wanjin1234/Silent-Mask-Microphone/microphone/windows/使用说明.txt

树莓派网络麦克风 · Windows 端
================================

这个文件夹里是电脑侧的程序，接收树莓派降噪后的麦克风音频并播放，同时把电脑的
声音（系统回环或麦克风）发回树莓派耳机口。

一、安装（只做一次）
--------------------
1) 装 Python 3.8 以上（https://www.python.org/downloads/ ，安装时勾选
   "Add python.exe to PATH"）。
2) 双击 **启动.bat**：它会自动执行 pip install soundcard numpy 然后打开界面。
   也可以手动：
       pip install -r requirements.txt
       python btmic_net_gui.py
   国内网络慢时加镜像：
       pip install -r requirements.txt -i https://pypi.tuna.tsinghua.edu.cn/simple

二、使用
--------
1) 界面上选连接方式：
     * TCP 直连 —— 树莓派和电脑在同一 WiFi/热点时用；电脑要有公网 IP 或做了
       内网穿透时，跨互联网也能用（音质最好：48kHz 立体声）。
     * MQTT 中继 —— 只要双方都能上网就行，不需要公网 IP（中继模式的音质和
       稳定性受免费 broker 限制）。
2) 点 **启动服务**。第一次会弹 Windows 防火墙提示，选"允许访问"。
   * **谁先开机都行**：树莓派连不上会每 4 秒重试一次，这里一点"启动服务"就接上；
     中途关掉本程序、之后再打开，树莓派也会自动重连，不用重启树莓派。
3) 点 **把连接参数复制给树莓派**，把复制到的命令粘到树莓派 SSH 里执行。
4) 底部 **音频自检** 可以在没连树莓派时先确认"电脑这边有没有声音"。

> 树莓派侧还有**智能切换蓝牙**：没有网络连接（比如这边还没启动服务）时它会自动
> 把蓝牙服务拉起来，手机/电脑可以继续用蓝牙；这边一启动服务，树莓派自动关掉蓝牙、
> 切到网络。详见上一级目录《4G模块安装与网络音频使用说明.md》的「六bis」一节。

三、界面上各块是干什么的
------------------------
① 连接设置：端口/broker/令牌（令牌两端必须一致，点"换一个"随机生成）
② 上行：树莓派麦克风 → 电脑。选播放设备、调音量、勾"同时录音到 WAV"
③ 下行：电脑声音 → 树莓派耳机口。选采集来源（"系统声音·xxx（回环）"=
   电脑正在放的所有声音；"麦克风·xxx"=你说的话）、调音量、
   "远端麦克风增益"相当于给树莓派的麦克风调音量（0~15）
④ 状态：连接状态、收发帧数、抖动缓冲、往返延迟
⑤ 日志：出问题先看这里

四、注意事项
------------
* 树莓派与电脑在同一个房间演示时，电脑建议戴耳机，否则会形成"树莓派喇叭 →
  树莓派麦克风 → 电脑 → 树莓派喇叭"的回声回路，可能啸叫。
* 下行格式（采样率/声道/帧长）**以树莓派宣布的为准**：树莓派开机时会把它的
  `NET_DOWNLINK_*` 通过握手告诉你，程序按它采集（日志里会写"按树莓派宣布的格式"）。
  界面上的"下行格式"只在树莓派还没宣布时兜底。两边不一致的后果是树莓派半速/变调
  播放（听感"低沉、失真"）——**所以不要用旧版程序**。
* ⚠️ 2026-09-27 修过一个 bug：旧版程序可能在收到树莓派的格式之前就按界面设置开始
  采集，导致上面那种变调/半速。**请使用随本次更新重新打包的
  `树莓派网络麦克风.exe`**（旧版已改名为桌面上的"旧版exe备份-可删.exe"，可直接删）。
* 完整说明（含 4G 模块安装、接线、固件、排查手册）见上一级目录的
  《4G模块安装与网络音频使用说明.md》。
* 改了界面上的设备/音量会存在 btmic_net_gui.json 里，下次自动带上。

五、自检（可选）
----------------
上一级的 tests/ 里有三个脚本，在本机跑一遍能验证协议与音频通路：
    python tests/test_proto.py      # 帧解析 + MQTT 报文解析 + 真 broker 收发
    python tests/test_e2e.py tcp    # 真声卡端到端（电脑↔"树莓派"双向音频）
    python tests/test_e2e.py mqtt   # 同上，走公共 broker

六、打包成单一 exe（免装 Python、没有控制台窗口）
------------------------------------------------
本目录里的 **树莓派网络麦克风.exe** 就是打包好的单文件程序（约 25MB）：
* 双击即用，**不需要装 Python**，也不会弹控制台窗口；「启动.bat」会优先用它。
* 配置与录音文件都保存在 **exe 旁边**（btmic_net_gui.json / *.wav）。
* 首次启动要解压自己，等 3~5 秒属正常。
* 没有数字签名，个别机器的 SmartScreen 会提示"未知发布者"——点"更多信息 → 仍要运行"。
* 想自己重新打包（改过源码后）：
      pip install pyinstaller
      pyinstaller --onefile --noconsole --name 树莓派网络麦克风 btmic_net_gui.py
* 出问题先跑自检（命令行里）：
      树莓派网络麦克风.exe --selftest
  它会把结果写到同目录的 btmic_selftest.txt（程序目录/配置路径/音频设备/闭环检查）。

七、采集来源怎么选（很重要，选错就"听不清"）
------------------------------------------------
* 「麦克风」= 你说的话 → **双向对讲必须选这个**（电脑说话，树莓派听见人声）。
* 「系统声音 · xx（回环）」= 电脑正在放的声音（音乐/视频），**不包括**你的说话。
* 若选「系统声音」而本程序又在同一路扬声器上播放树莓派的声音，就形成闭环：
  树莓派会听见自己的回声（听起来是"有响声但听不清内容"）。程序检测到这种组合会
  在界面上红字告警，并给出「改用麦克风」一键切换。
* 想让树莓派耳机里听到**电脑在放的音乐/视频**（而不是你的说话）：先把这里切成
  「系统声音 · xx（回环）」，并且电脑最好戴耳机（否则又会形成上面那个闭环）。

八、树莓派耳机没声音怎么办
--------------------------------
先在电脑上看第 ③ 块的电平表：有跳说明音频已经发过去了，问题在树莓派"放到哪个孔"。
树莓派侧的排查（`PLAYBACK_DEVICE` 写的是哪张卡、怎么确认耳机插在哪张卡、多个设备
同时送）见上一级《4G模块安装与网络音频使用说明.md》"八、排查手册"里
「电脑→树莓派没声音」那一节。
