wanjin1234/Silent-Mask-Microphone/microphone/接线图/1_模块接口位置.png

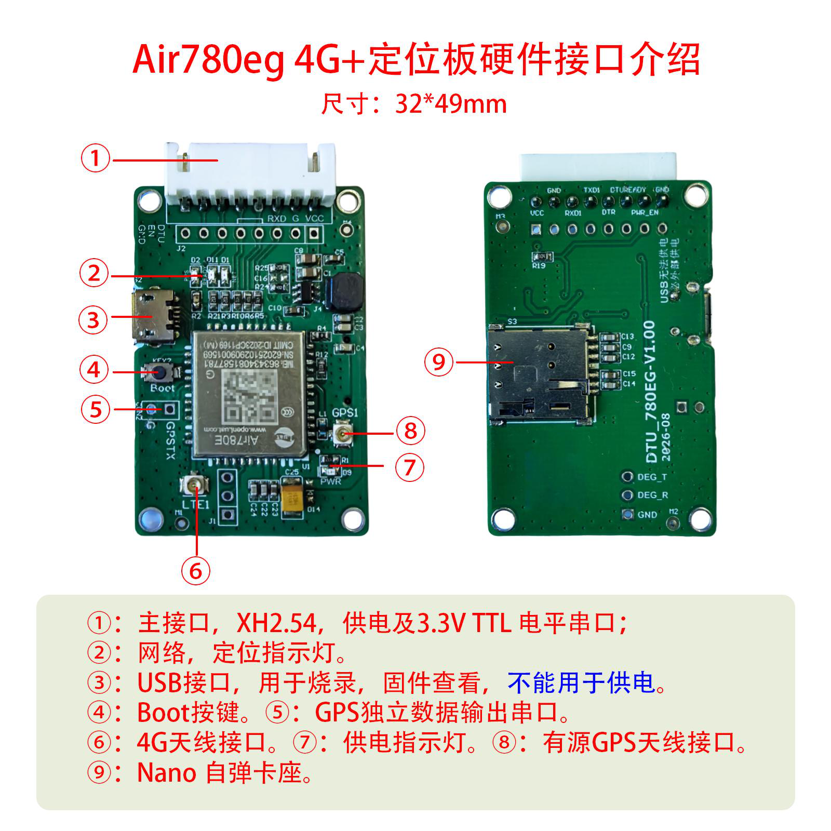
microphone/接线图/1_模块接口位置.png
