wanjin1234/Silent-Mask-Microphone/microphone/接线图/2_接电脑_USB线.png

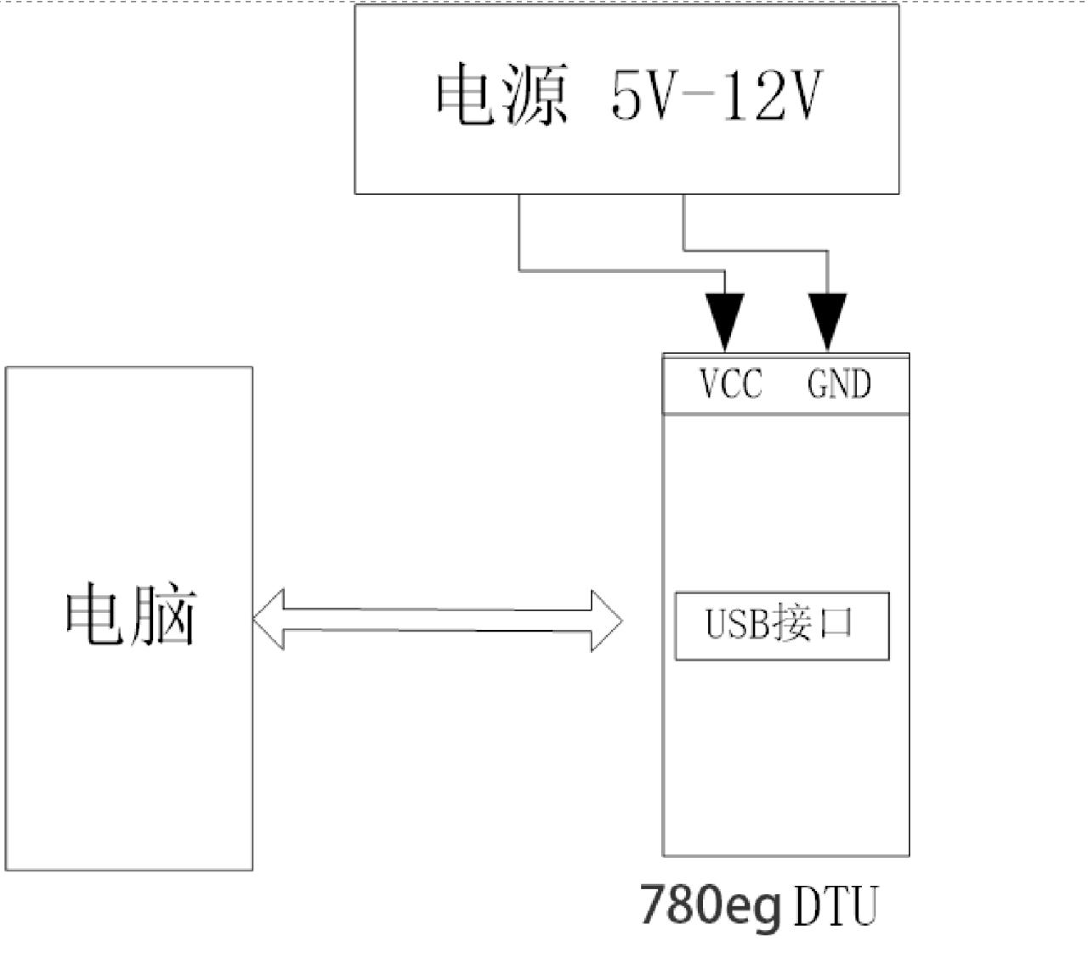
microphone/接线图/2_接电脑_USB线.png
