wanjin1234/Silent-Mask-Microphone/microphone/接线图/3_接电脑_TTL串口.png

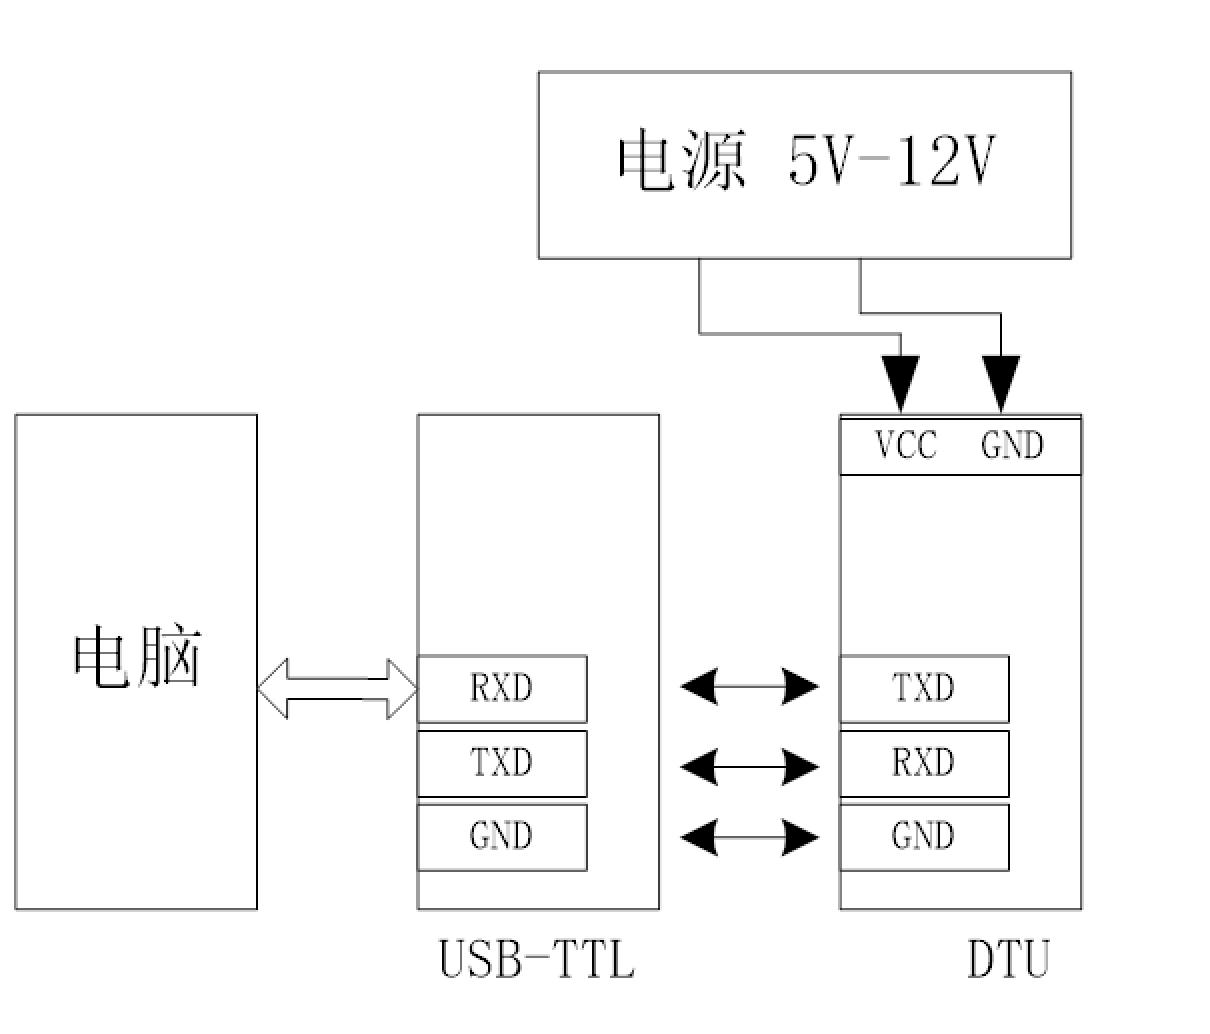
microphone/接线图/3_接电脑_TTL串口.png
