wanjin1234/Silent-Mask-Microphone/microphone/接线图/4_接单片机_TTL串口.png

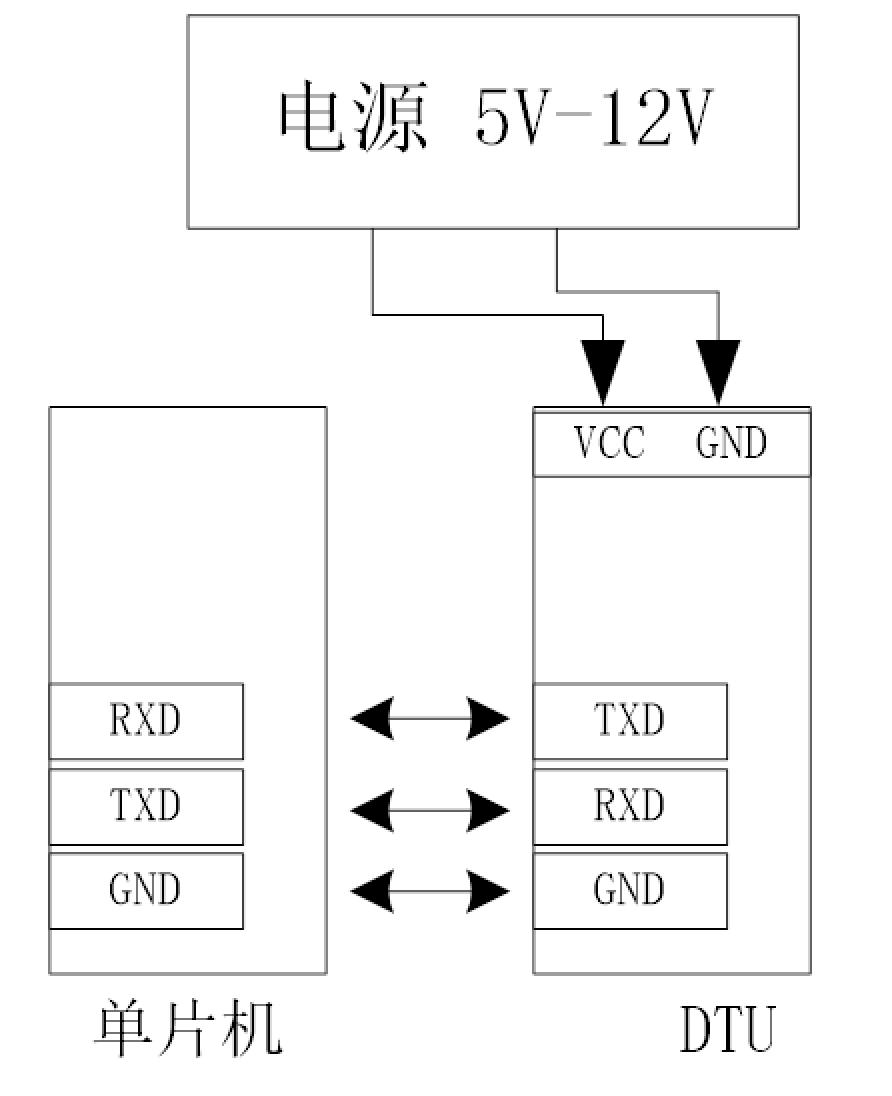
microphone/接线图/4_接单片机_TTL串口.png
