wanjin1234/Silent-Mask-Microphone/3d_model/component_2.SLDPRT

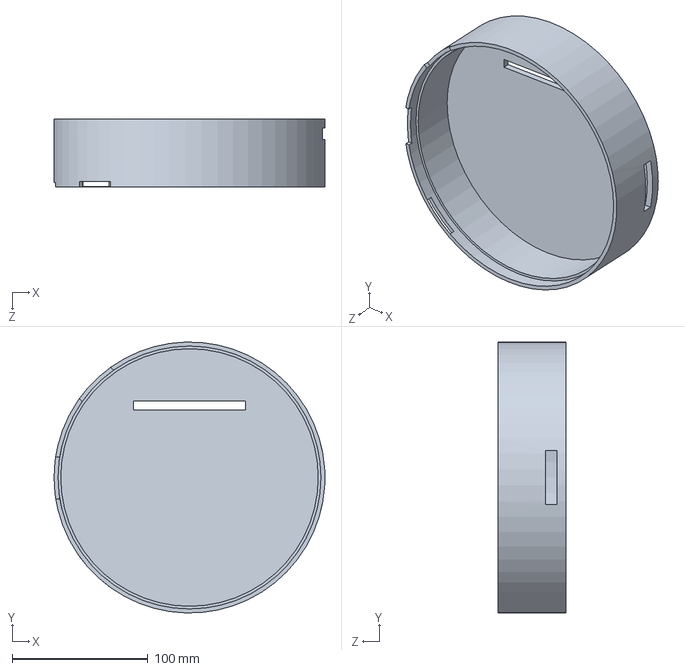
[picture p6: CAD file, 2026-09-27]
3d_model/component_2.SLDPRT
200.0 x 199.9 x 50.0 mm
