wanjin1234/Silent-Mask-Microphone/3d_model/component_1.SLDPRT

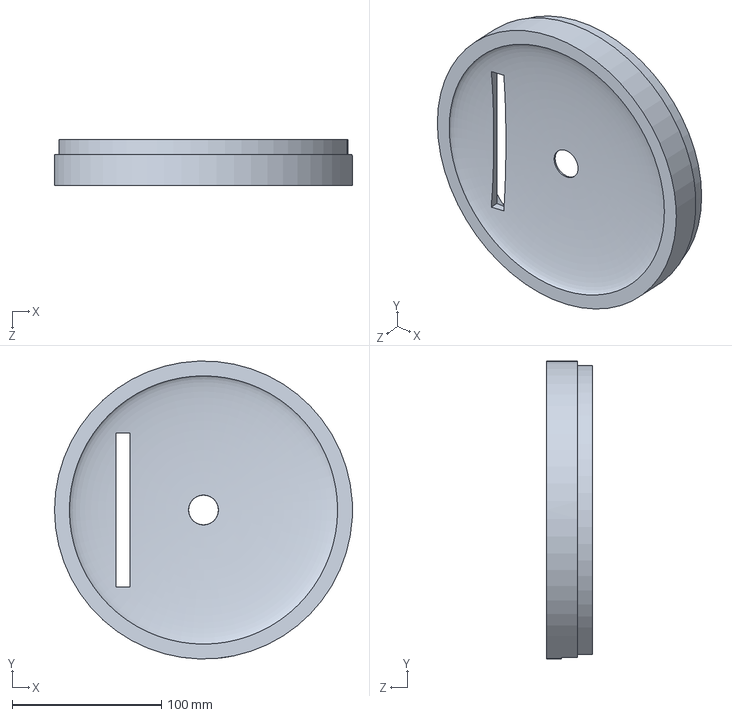
[picture p7: CAD file, 2026-09-27]
3d_model/component_1.SLDPRT
200.0 x 199.9 x 31.0 mm
