wanjin1234/Silent-Mask-Microphone/view/thermal_ai/model_io.py

# -*- coding: utf-8 -*-
"""模型加载：自动识别 TensorFlow / TFLite / numpy 后端。

查找顺序（与 ``src/test_ai/test_ai/model_io.py`` 同一约定）：

1. ``<dir>/<name>.keras``       → 完整 TensorFlow 后端
2. ``<dir>/<name>.tflite``      → TFLite 后端（树莓派推荐，最轻）
3. ``<dir>/<name>_numpy.npz``   → 纯 numpy 逻辑回归后端

``predict_fn(frames)`` 接收原始温度帧（shape ``(N, 24, 32)`` 或 ``(N, 768)``），
返回 ``(N,)`` 的 ``P(有人)`` 概率数组（内部完成温度归一化）。
"""

from __future__ import annotations

import json
import os

import numpy as np

from preprocess import frame_to_tensor, T_MIN, T_MAX


def load_model(model_dir, name="presence_model"):
    """加载模型与元数据，返回 ``(predict_fn, meta, backend)``。"""
    meta_path = os.path.join(model_dir, name + "_meta.json")
    if not os.path.exists(meta_path):
        raise SystemExit(
            f"找不到 {meta_path}\n"
            f"  请先训练：python train.py --data <数据.npz> --out-dir {model_dir}")
    with open(meta_path, "r", encoding="utf-8") as f:
        meta = json.load(f)
    t_min = float(meta.get("t_min", T_MIN))
    t_max = float(meta.get("t_max", T_MAX))

    keras_path = os.path.join(model_dir, name + ".keras")
    tflite_path = os.path.join(model_dir, name + ".tflite")
    npz_path = os.path.join(model_dir, name + "_numpy.npz")

    if os.path.exists(keras_path):
        try:
            import tensorflow as tf
            model = tf.keras.models.load_model(keras_path)

            def predict(frames):
                return model.predict(frame_to_tensor(frames, t_min, t_max),
                                     verbose=0).ravel().astype(np.float32)
            return predict, meta, "tf"
        except Exception as e:
            print(f"[WARN] TF 模型加载失败（{e}），尝试其它后端")

    if os.path.exists(tflite_path):
        interp_pred = _load_tflite(tflite_path, t_min, t_max)
        if interp_pred is not None:
            return interp_pred, meta, "tflite"

    if os.path.exists(npz_path):
        from thermal_numpy import NumpyLogReg
        model = NumpyLogReg.load(npz_path)

        def predict(frames):
            x = frame_to_tensor(frames, t_min, t_max).reshape(len(frames), -1)
            return model.predict_proba(x)
        return predict, meta, "numpy"

    raise SystemExit(
        f"{model_dir} 下既没有 {name}.keras / {name}.tflite 也没有 {name}_numpy.npz")
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
