wanjin1234/Silent-Mask-Microphone/(commit log)

2026-09-27 加入树莓派网络麦克风：降噪上行 + 电脑音频下行（TCP/MQTT/4G）
    树莓派端 final_btmic.py 新增网络模式（--net）：
    - 上行复用原有 arecord→DeepFilterNet→增益 管道，只把蓝牙那一段换成网络桥
    - 下行 net-recv→重采样→电平表→aplay（耳机口），自动重采样到设备原生速率
    - 三种链路：TCP 直连 / MQTT 中继 / 4G 模块串口 PPP（含拨号一条命令）
    - 诊断命令：--net-4g / --net-4g-at / --net-4g-ppp-up / --net-probe / --net-status
    Windows 端 windows/：图形界面（设备选择、电平表、录音、令牌一键复制）+
    打包好的单文件 exe（无控制台）；启动.bat 优先用 exe
    文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
2026-09-27 整理仓库结构：microphone / view / 3d_model 三个模块
    - microphone/：树莓派网络麦克风（降噪上行 + 电脑音频下行；蓝牙 / TCP 直连 /
    MQTT 中继 / 4G 串口 PPP 四种链路），含 Windows 图形界面源码与单文件 exe、
    使用说明、接线图、自检脚本
    - view/：热成像 / 雷达 / AI 视觉 / 部署脚本等
    - 3d_model/：结构件 SLDPRT 模型
    - 根 README 保留项目说明（多感智能降噪消防面具）
    未纳入版本库（见 .gitignore）：4G 模块厂商资料（Luatools_v2.rar 133MB，
    超过 GitHub 单文件上限 100MB）、Python 虚拟环境、__pycache__ 等运行产物
    [component_1.SLDPRT, component_2.SLDPRT]
2026-09-27 修正 .gitignore：build/dist/*.spec 只针对仓库根目录
    避免把各模块自己要发布的构建产物（如 view/radarpi/dist/radarpi_1.0.0_all.deb）
    一起排除掉。
2026-09-27 网络模式：自动重连 + 智能切换蓝牙
    - 连不上/中途掉线都无限重试（NET_RETRY_SECS，默认 4 秒），谁先开机都行
    - 没网络连接时自动拉起蓝牙服务，探到电脑上线就停蓝牙让出麦克风；
    电脑下线超过 NET_OFFLINE_SECS 即结束会话、把蓝牙还回来（NET_AUTO_BT=1）
    - 修 systemd Conflicts 双向互停：网络模式 start bt-mic 时被 systemd 把自己停掉
    - 修开始顺序：先让蓝牙可用再拨 4G（拨号要 30~50 秒，不必干等）
    - bt-mic.service 加 KillMode=mixed/TimeoutStopSec=8：辅助进程不退导致停止卡 30 秒
    并把 unit 标成 failed（停止耗时 30 秒 → 2 秒）
    - 文档补充「六bi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
2026-09-27 修「树莓派耳机听不见电脑声音」：放音设备认名字、支持多设备镜像
    - 根因：/etc/default/bt-mic 里 MIC/PLAYBACK 两个 dongle 写反了（耳机插在 card3
    Audio_1 的孔上，放音却送到 card2——麦克风自己那张卡），数据一路写进没有耳机的孔
    - _playback_card 只认 hw:N 数字形式，CARD=Audio 这种名字形式一律当 card0，
    于是「放音送到了麦克风自己那张卡」这个保护完全失效（实测踩到）；
    现在按 /proc/asound/<id> 解析出真实卡号，final_btmic.py 与 auto_btmic.py 都修
    - PLAYBACK_DEVICE 支持写多个设备（逗号分隔）：第一个是主设备、其余是镜像，
    新增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
2026-09-27 修「延迟大 + 声音失真低沉」：耳机音量被写成 0、同名声卡 id 重启互换
    1) 蓝牙脚本 amixer_set 的 cset 用法会写 0：
    `amixer cset name='Headphone' unmute` 不报错但把 0 写进音量控制（-50dB），
    蓝牙模式启动 10~20 秒后耳机音量变 0%。实测修前 45 秒内掉到 0%，修后稳定 100%。
    两个脚本统一"cset 只用于数值，unmute/on/off 只走 sset"。
    2) 同型号 USB dongle 的卡号/id（Audio / Audio_1）重启后会互换，而配置把
    MIC_DEVICE/PLAYBACK_DEVICE 钉在这两个名字上 → 放音送到麦克风那张卡，
    同一路 USB 时钟既采又放 → 一会 underrun 一会丢帧、缓冲来回抖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
2026-09-27 修「延迟一直涨 + 耳机声音低沉失真」：电脑端下行没按树莓派宣布的格式发
    根因（2026-09-27 实测定位）：树莓派的 hello 里带着下行格式（8000Hz 单声道 200ms），
    但电脑端的采集线程在收到该 hello 之前就被"对端在线"触发起来了（那个"在线"是被树莓派
    的 pong 提前点亮的），fmt 仍为空 → 退回用界面设置值（16kHz）发送。树莓派按 8kHz 播
    16kHz 的数据 = 半速 + 低八度（"低沉/失真"），数据量还翻倍（32KB/s vs 16KB/s）→
    抖动缓冲丢掉 26~50% 的帧（听感"又低又破"），队列越堆越长（延迟一直涨）。
    - 电脑端 btmic_net_gui.py：
    * _on_hell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
2026-09-27 文档与部署配置对齐（当前上下行均 16kHz，低延迟档位说明要求先换新 exe）
2026-09-27 修「延迟一直上涨」：发送节拍 1.5 倍 + μ-law 帧长算错；新增 μ-law 编码
    定位（真机实测）：树莓派把音频**发多了**——4G 一条方向只稳定跑 ~45KB/s，
    发超了就堆在模块缓冲里，越堆越久（就是"延迟一直涨"）。
    1) 上行发送节拍写成 frame_ms/1.5 并每帧 +=，等于长期 1.5 倍速发：
    电脑端实测收到 7.5 帧/秒（应 5.0）、音频内容 1.5 倍速、播放队列顶满丢 1/3。
    改成「正常按一帧时长、落后才允许 1.5 倍追赶」，实测电脑端 5.03 帧/秒、1.007 倍。
    2) 下行播放节拍用了编码后的 bytes_per_ms（μ-law 减半）而帧字节数是解码后的
    →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
2026-09-27 修「上行音频块被截断/失真」：发送节拍里的 max(..., now) 会造成"突发送+空档"
    上一次修 1.5 倍速时写成 `next_send = max(next_send + step, now)`：生产端是实时的，
    "落后"是常态，于是每次都把节拍重置成"现在"、下一帧立刻发 → 变成突发送几帧 +
    长空档 → 电脑端播放器频繁 underrun，听感就是"音频块被一段段截断、降噪后声音失真"。
    改成：正常严格按一帧时长推进（200ms），落后超过一帧才按 1.5 倍平滑追赶，
    只有落后 1 秒以上（断线重连）才重新对表。既保住 1.0 倍速，也不再突发送。
2026-09-27 修「上行音频块被截断/0.5 倍速失真」：切块用了编码后的帧长
    μ-law 每样本 1 字节、s16le 是 2 字节，而上行 stdin 切块与下行静音填充都按
    fmt.frame_bytes（编码后）算 → 每帧实际只有 100ms（应 200ms），电脑端按 200ms/帧
    播放 → 内容 0.5 倍速、成块状（听感"低沉、被截断、失真"）。
    现在两处都按 s16le 帧长算（pcm_frame_bytes = rate*frame_ms/1000*channels*2）。
    注：上一提交里这两处补丁因为脚本中途报错没有真正写入，本次确认已写入并真机验证：
    电脑端收到上行 3200 字节/帧、帧间隔中位 200ms、下行 0 丢帧、抖动缓冲 200ms。
